LegumeEmittingDiode/tt08-tiny-pll/README.md

# Tiny PLL
A 4-channel fractional-N PLL for Tiny Tapeout 8 in a 1x1 digital tile.

[Read the documentation for this project](/docs/info.md)

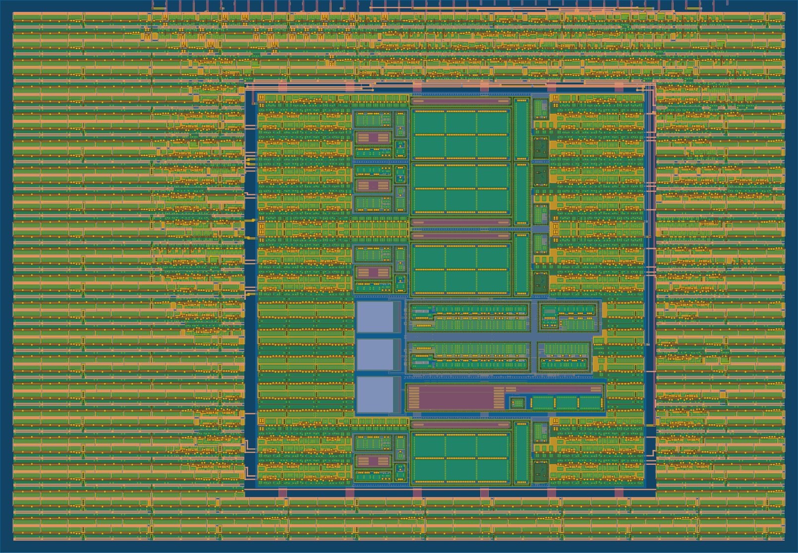
[picture p1: docs/images/render.png]
GDS render
