LegumeEmittingDiode/tt08-tiny-pll/(commit log)

2024-09-06 Add screenshots, verilog files and schematics.
2024-09-06 Add xschem files.
    [tiny_adc.sch, tiny_adc_bias_gen.sch, tiny_adc_comp.sch, tiny_adc_integ.sch, tiny_adc_integ_cap.sch, tiny_adc_integ_res.sch, tiny_adc_opamp.sch, tiny_adc_vref_gen.sch]
2024-09-08 Add combo scripts.
    [combo.csv]
2024-09-08 Move scripts to docs.
    [combo.csv]
